twinter145/ECE445/README.md

# ECE445
ECE 445 Senior Design Project LED Photography Light
