twinter145/ECE445/MCU-PCB-Design/MCU-PCB-schematic.brd

## EAGLE design MCU-PCB-Design/MCU-PCB-schematic.brd (2023-06-06)

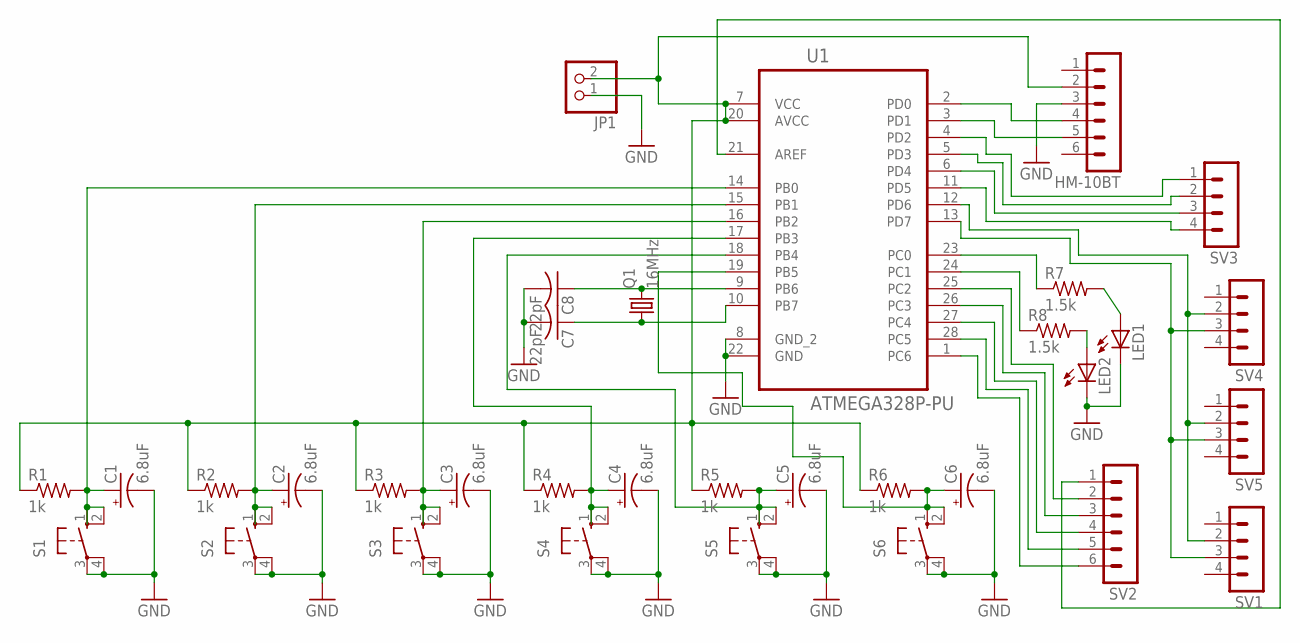
[picture p14: schematic MCU-PCB-schematic.sch]

Parts:
C1, C2, C3, C4, C5, C6: 6.8uF; E2,5-5
C7, C8: 22pF; C025-024X044
HM-10BT: MA06-1
JP1: PINHD-1X2; 1X02
LED1, LED2: LED5MM
Q1: 16MHz; HC49/S
R1, R2, R3, R4, R5, R6: 1k; 0207/10
R7, R8: 1.5k; 0207/10
S1, S2, S3, S4, S5, S6: 10-XX; B3F-10XX
SV1, SV3, SV4, SV5: MA04-1
SV2: MA06-1
U1: ATMEGA328P-PU; DIP254P762X457-28

Connections:
GND: C1.-, C2.-, C3.-, C4.-, C5.-, C6.-, C7.2, C8.2, HM-10BT.3, JP1.1, LED1.K (C), LED2.K (C), S1.3, S1.4 (P1), S2.3, S2.4 (P1), S3.3, S3.4 (P1), S4.3, S4.4 (P1), S5.3, S5.4 (P1), S6.3, S6.4 (P1), U1.8 (GND_2), U1.22 (GND)
unnamed: HM-10BT.2, JP1.2, R1.1, R2.1, R3.1, R4.1, R5.1, R6.1, U1.7 (VCC), U1.20 (AVCC)
unnamed: C1.+, R1.2, S1.1 (S), S1.2 (S1), U1.14 (PB0)
unnamed: C5.+, R5.2, S5.1 (S), S5.2 (S1), U1.18 (PB4)
unnamed: C6.+, R6.2, S6.1 (S), S6.2 (S1), U1.19 (PB5)
unnamed: C8.1, Q1.2, U1.9 (PB6)
unnamed: C7.1, Q1.1, U1.10 (PB7)
unnamed: HM-10BT.4, U1.2 (PD0)
unnamed: HM-10BT.5, U1.3 (PD1)
unnamed: R7.1, U1.23 (PC0)
unnamed: R8.1, U1.24 (PC1)
unnamed: LED1.A, R7.2
unnamed: LED2.A, R8.2
unnamed: SV1.3, SV4.3, SV5.3, U1.13 (PD7)
unnamed: SV1.2, SV4.2, SV5.2, U1.12 (PD6)
unnamed: SV2.2, U1.25 (PC2)
unnamed: SV2.3, U1.26 (PC3)
unnamed: SV2.4, U1.27 (PC4)
unnamed: SV2.5, U1.28 (PC5)
unnamed: SV2.6, U1.1 (PC6)
unnamed: SV2.1, U1.21 (AREF)
unnamed: C3.+, R3.2, S3.1 (S), S3.2 (S1), U1.16 (PB2)
unnamed: SV3.2, U1.5 (PD3)
unnamed: SV3.3, U1.6 (PD4)
unnamed: SV3.4, U1.11 (PD5)
unnamed: SV3.1, U1.4 (PD2)
unnamed: C2.+, R2.2, S2.1 (S), S2.2 (S1), U1.15 (PB1)
unnamed: C4.+, R4.2, S4.1 (S), S4.2 (S1), U1.17 (PB3)

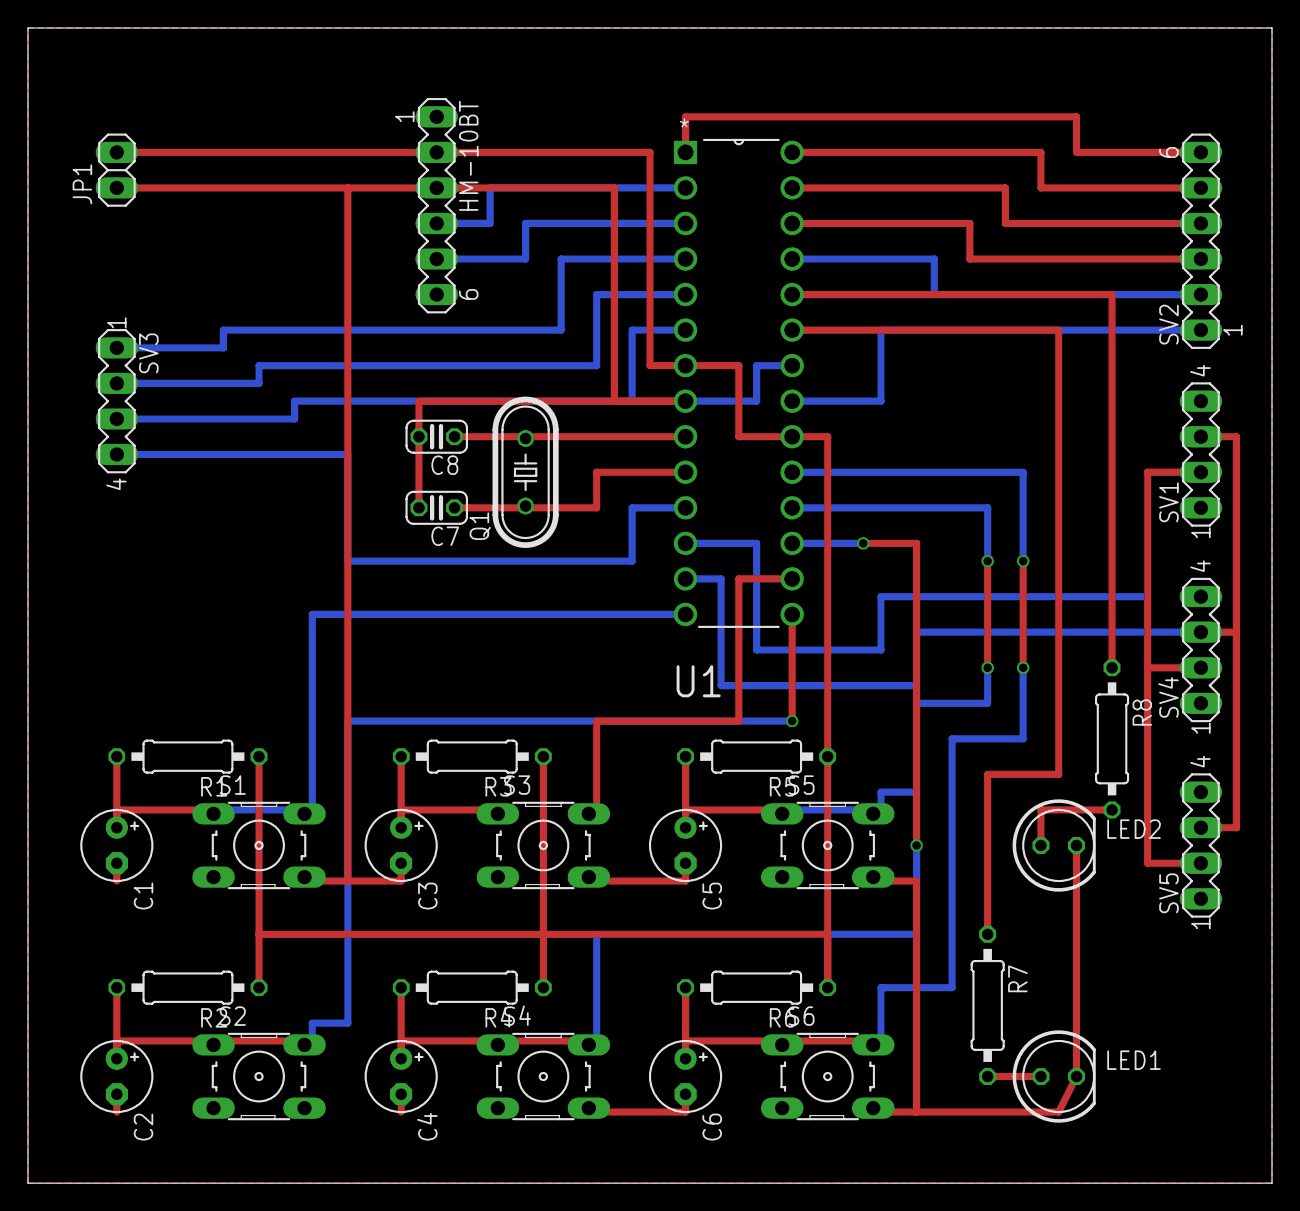
[picture p15: board MCU-PCB-schematic.brd from above]

Board: 2 copper layers, 88.9 x 82.5 mm, 33 parts (0 on the bottom side), 28 nets.
